btao732/ECE492/Platform/Platform.runs/impl_1/.init_design.begin.rst

<?xml version="1.0"?>
<ProcessHandle Version="1" Minor="0">
    <Process Command=".planAhead." Owner="Moose" Host="DESKTOP-4VIHOFO" Pid="2448">
    </Process>
</ProcessHandle>
