btao732/ECE492/Platform/Platform.runs/impl_1/.vivado.begin.rst

<?xml version="1.0"?>
<ProcessHandle Version="1" Minor="0">
    <Process Command="vivado.bat" Owner="Moose" Host="DESKTOP-4VIHOFO" Pid="16036" HostCore="16" HostMemory="016387657728">
    </Process>
</ProcessHandle>
