btao732/ECE492/PCB/SPARC Capstone Preliminary BOM.xlsx

Reference | Value | MFR | Mfr P/N | Mouser P/N | Digikey P/N | Qty | Unit Price | Ext Price | Notes
C1-C6 | 0.22uF | TDK | CGA6M4X7T2W224M200AA | 810-CGA6M4X7T2W224MA | 445-13048-1-ND | 10 | $0.74 | $7.45
C7, C9, C11, C12 | 0.1uF | Murata | GC332DD72W104KX01L | 81-GC332DD72W104KX1L | 490-14002-1-ND | 10 | $1.07 | $10.70
C8, C10 | 1uF | Samsung | CL10B105KP8NNNC | 187-CL10B105KP8NNNC | 1276-1946-1-ND | 10 | $0.06 | $0.56
D1 | Bridge Rectifier | Diodes Inc. | HDS10M-13 | 621-HDS10M-13 | HDS10M-13DICT-ND | 1 | $0.65 | $0.65 | As specified in given schematic
J1-J2 | SMA Connector | Molex | 732511150 | 538-73251-1150 | WM5534-ND | 2 | $6.41 | $12.82 | As specified in given schematic
J3, J6 | 6-Pin Header | Adam Tech | PH1-06-UA | 523-G800W302018EU | 2057-PH1-06-UA-ND | 2 | $0.19 | $0.38 | Mouser P/N is a different, compatable part
J4, J5, JP1 | 3-Pin header | Adam Tech | PH1-03-UA | 523-G800W305018EU | 2057-PH1-03-UA-ND | 3 | $0.15 | $0.45 | Mouser P/N is a different, compatable part
JP2-JP5 | 6-Pin Header | Adam Tech | PH2-06-UA |  | 2057-PH2-06-UA-ND | 2 | $0.19 | $0.38
R1-R62 | 75KΩ | Rohm | ESR03EZPF7502 | 755-ESR03EZPF7502 | RHM75.0KADCT-ND | 100 | $0.08 | $8.00
U1 | Switch | Microchip | HV2621/R4X | 579-HV2621/R4X | 150-HV2621/R4X-ND | 2 | $40.27 | $80.54 | $42.39 From Digikey
 |  |  |  |  |  |  | Total | $121.93
