btao732/ECE492/PCB/SPARC.kicad_pcb

## KiCad design PCB/SPARC.kicad_pcb (2023-03-10)

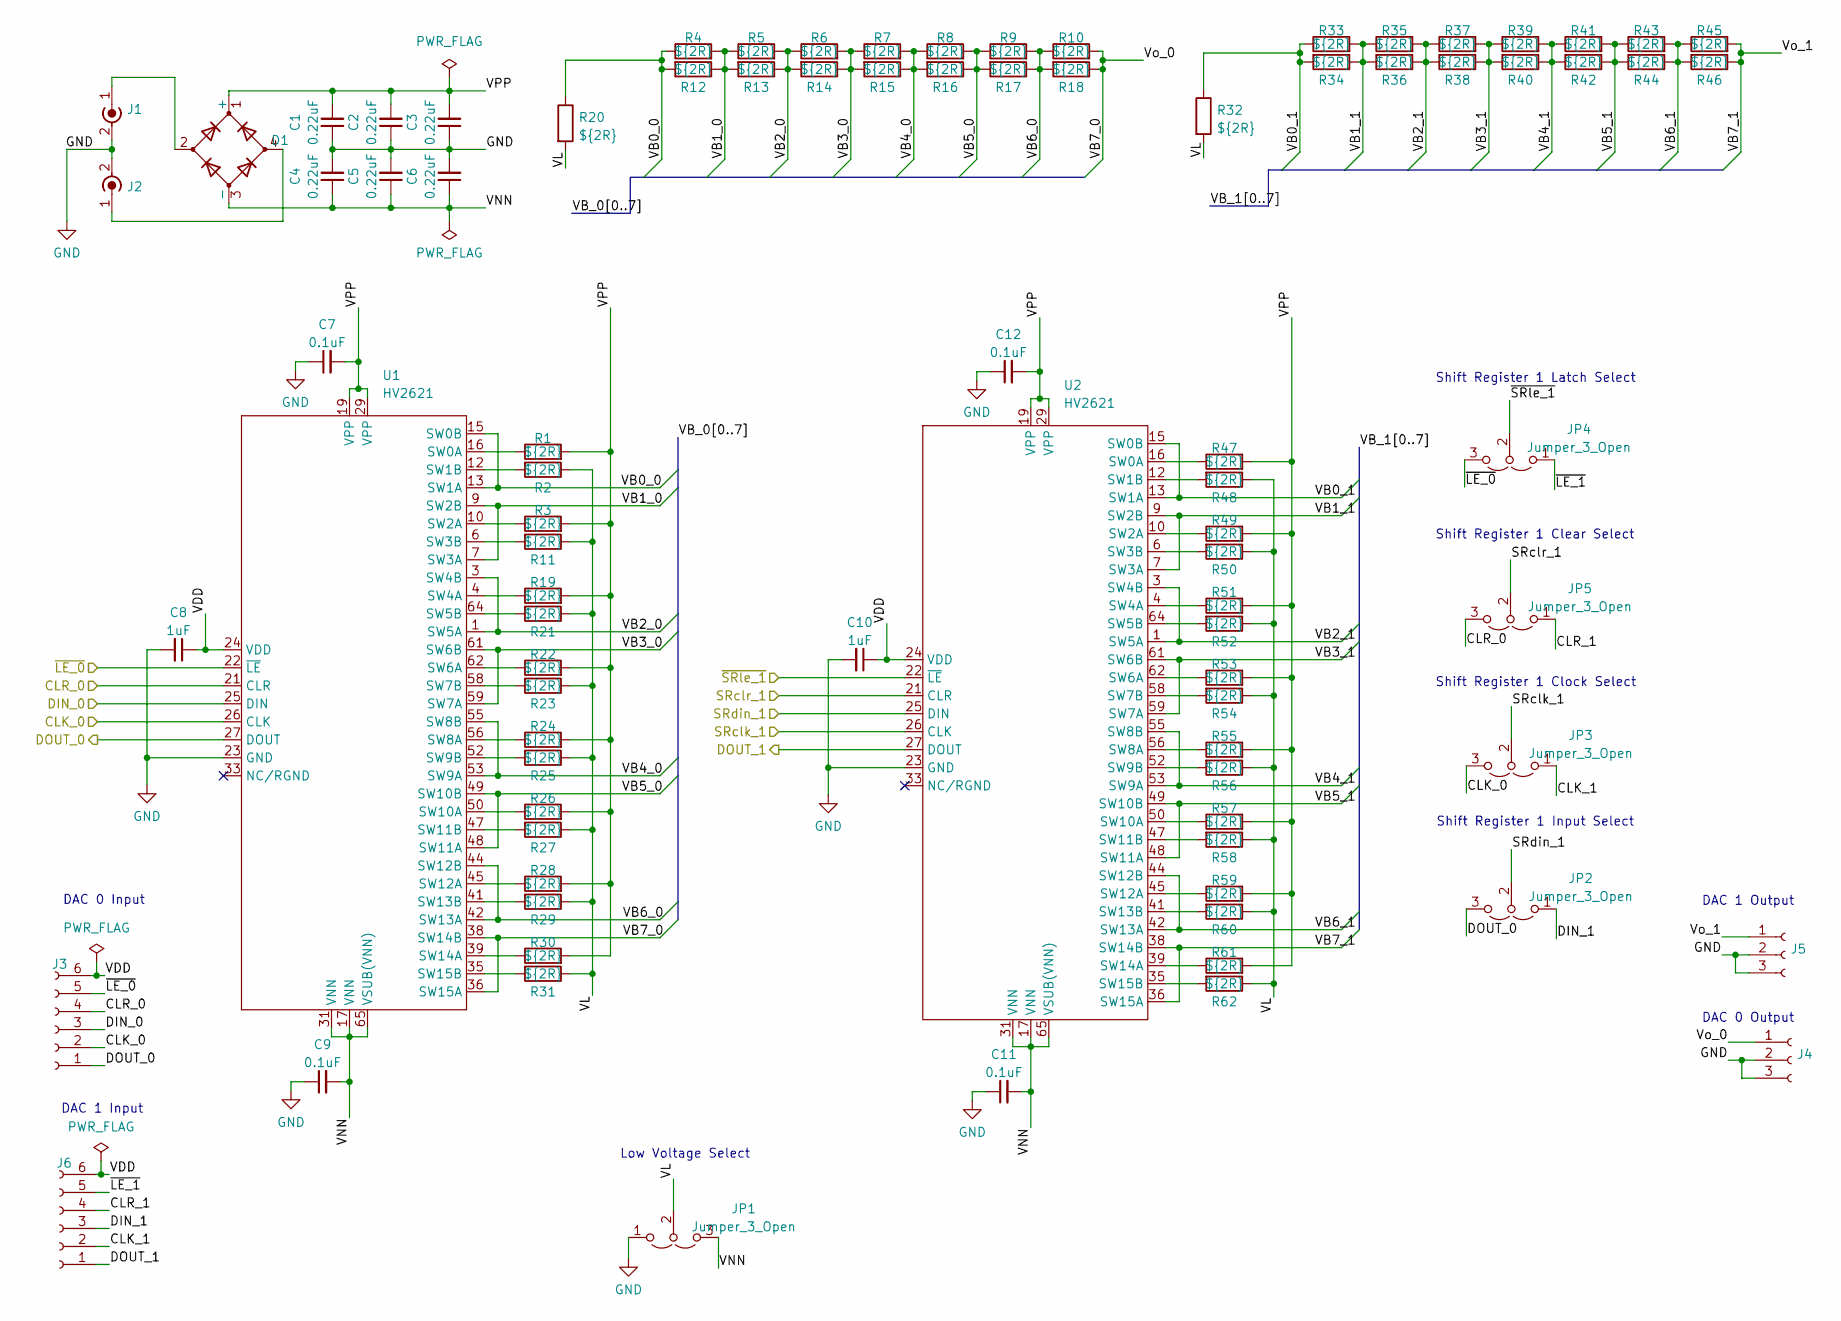
[picture p1: schematic SPARC.kicad_sch, HVDAC - SPARC Capstone]

Parts:
C1, C2, C3, C4, C5, C6: 0.22uF; C_1210_3225Metric
C7, C9, C11, C12: 0.1uF; C_1210_3225Metric_Pad1.33x2.70mm_HandSolder
C8, C10: 1uF; C_0603_1608Metric
D1: D_Bridge_+A-A; Package_HDS
J1, J2: Conn_Coaxial_Power; SMA_Molex_73251-1153_EdgeMount_Horizontal
J3, J6: Conn_01x06_Female; PinHeader_1x06_P2.54mm_Vertical
J4, J5: Conn_01x03_Female; PinHeader_1x03_P2.54mm_Vertical
JP1, JP2, JP3, JP4, JP5: Jumper_3_Open; PinHeader_1x03_P2.54mm_Vertical
R1, R2, R3, R4, R5, R6, R7, R8, R9, R10, R11, R12, R13, R14, R15, R16, R17, R18, R19, R20, R21, R22, R23, R24, R25, R26, R27, R28, R29, R30, R31, R32, R33, R34, R35, R36, R37, R38, R39, R40, R41, R42, R43, R44, R45, R46, R47, R48, R49, R50, R51, R52, R53, R54, R55, R56, R57, R58, R59, R60, R61, R62: ${2R}; R_0603_1608Metric_small_silk
U1, U2: HV2621; VQFN-64-1EP_9x9mm_P0.5mm_EP7.15x7.15mm_ThermalVias

Connections:
/CLK_0: J3.2, JP3.3 (B), U1.26 (CLK); also elsewhere on the board
/CLK_1: J6.2, JP3.1 (A); also elsewhere on the board
/CLR_0: J3.4, JP5.3 (B), U1.21 (CLR); also elsewhere on the board
/CLR_1: J6.4, JP5.1 (A); also elsewhere on the board
/DIN_0: J3.3, U1.25 (DIN)
/DIN_1: J6.3, JP2.1 (A); also elsewhere on the board
/DOUT_0: J3.1, JP2.3 (B), U1.27 (DOUT); also elsewhere on the board
/DOUT_1: J6.1, U2.27 (DOUT)
/SRclk_1: U2.26 (CLK); also elsewhere on the board
/SRclr_1: U2.21 (CLR); also elsewhere on the board
/SRdin_1: U2.25 (DIN); also elsewhere on the board
/VB0_0: R4.1, R12.2, R20.1, U1.13 (SW1A), U1.15 (SW0B)
/VB0_1: R32.1, R33.1, R34.2, U2.13 (SW1A), U2.15 (SW0B)
/VB1_0: R4.2, R5.1, R12.1, R13.2, U1.7 (SW3A), U1.9 (SW2B)
/VB1_1: R33.2, R34.1, R35.1, R36.2, U2.7 (SW3A), U2.9 (SW2B)
/VB2_0: R5.2, R6.1, R13.1, R14.2, U1.1 (SW5A), U1.3 (SW4B)
/VB2_1: R35.2, R36.1, R37.1, R38.2, U2.1 (SW5A), U2.3 (SW4B)
/VB3_0: R6.2, R7.1, R14.1, R15.2, U1.59 (SW7A), U1.61 (SW6B)
/VB3_1: R37.2, R38.1, R39.1, R40.2, U2.59 (SW7A), U2.61 (SW6B)
/VB4_0: R7.2, R8.1, R15.1, R16.2, U1.53 (SW9A), U1.55 (SW8B)
/VB4_1: R39.2, R40.1, R41.1, R42.2, U2.53 (SW9A), U2.55 (SW8B)
/VB5_0: R8.2, R9.1, R16.1, R17.2, U1.48 (SW11A), U1.49 (SW10B)
/VB5_1: R41.2, R42.1, R43.1, R44.2, U2.48 (SW11A), U2.49 (SW10B)
/VB6_0: R9.2, R10.1, R17.1, R18.2, U1.42 (SW13A), U1.44 (SW12B)
/VB6_1: R43.2, R44.1, R45.1, R46.2, U2.42 (SW13A), U2.44 (SW12B)
/VB7_0: J4.1, R10.2, R18.1, U1.36 (SW15A), U1.38 (SW14B)
/VB7_1: J5.1, R45.2, R46.1, U2.36 (SW15A), U2.38 (SW14B)
/VDD: C8.1, C10.1, J3.6, J6.6, U1.24 (VDD), U2.24 (VDD)
/VL: JP1.2 (C), R2.1, R11.1, R20.2, R21.1, R23.1, R25.1, R27.1, R29.1, R31.1, R32.2, R48.1, R50.1, R52.1, R54.1, R56.1, R58.1, R60.1, R62.1
/VNN: C4.1, C5.1, C6.1, C9.2, C11.2, D1.3 (-), JP1.3 (B), U1.17 (VNN), U1.31 (VNN), U1.65 (VSUB(VNN)), U2.17 (VNN), U2.31 (VNN), U2.65 (VSUB(VNN))
/VPP: C1.2, C2.2, C3.2, C7.2, C12.2, D1.1 (+), R1.2, R3.2, R19.2, R22.2, R24.2, R26.2, R28.2, R30.2, R47.2, R49.2, R51.2, R53.2, R55.2, R57.2, R59.2, R61.2, U1.19 (VPP), U1.29 (VPP), U2.19 (VPP), U2.29 (VPP); also elsewhere on the board
/~LE_0: J3.5, JP4.3 (B), U1.22 (~LE); also elsewhere on the board
/~LE_1: J6.5, JP4.1 (A); also elsewhere on the board
/~SRle_1: U2.22 (~LE); also elsewhere on the board
GND: C1.1, C2.1, C3.1, C4.2, C5.2, C6.2, C7.1, C8.2, C9.1, C10.2, C11.1, C12.1, J1.2 (Ext), J2.2 (Ext), J4.2, J4.3, J5.2, J5.3, JP1.1 (A), U1.23 (GND), U2.23 (GND)
unnamed: D1.2, J1.1 (In)
unnamed: D1.4, J2.1 (In)
unnamed: R1.1, U1.16 (SW0A)
unnamed: R2.2, U1.12 (SW1B)
unnamed: R3.1, U1.10 (SW2A)
unnamed: R11.2, U1.6 (SW3B)
unnamed: R19.1, U1.4 (SW4A)
unnamed: R21.2, U1.64 (SW5B)
unnamed: R22.1, U1.62 (SW6A)
unnamed: R23.2, U1.58 (SW7B)
unnamed: R24.1, U1.56 (SW8A)
unnamed: R25.2, U1.52 (SW9B)
unnamed: R26.1, U1.50 (SW10A)
unnamed: R27.2, U1.47 (SW11B)
unnamed: R28.1, U1.45 (SW12A)
unnamed: R29.2, U1.41 (SW13B)
unnamed: R30.1, U1.39 (SW14A)
unnamed: R31.2, U1.35 (SW15B)
unnamed: R47.1, U2.16 (SW0A)
unnamed: R48.2, U2.12 (SW1B)
unnamed: R49.1, U2.10 (SW2A)
unnamed: R50.2, U2.6 (SW3B)
unnamed: R51.1, U2.4 (SW4A)
unnamed: R52.2, U2.64 (SW5B)
unnamed: R53.1, U2.62 (SW6A)
unnamed: R54.2, U2.58 (SW7B)
unnamed: R55.1, U2.56 (SW8A)
unnamed: R56.2, U2.52 (SW9B)
unnamed 63: R57.1, U2.50 (SW10A); also elsewhere on the board
unnamed: R58.2, U2.47 (SW11B)
unnamed: R59.1, U2.45 (SW12A)
unnamed: R60.2, U2.41 (SW13B)
unnamed: R61.1, U2.39 (SW14A)
unnamed: R62.2, U2.35 (SW15B)

Notes on the sheet:
DAC 1 Output
Low Voltage Select
DAC 0 Output
Shift Register 1 Clear Select
Shift Register 1 Latch Select
DAC 1 Input
DAC 0 Input
Shift Register 1 Input Select
Shift Register 1 Clock Select

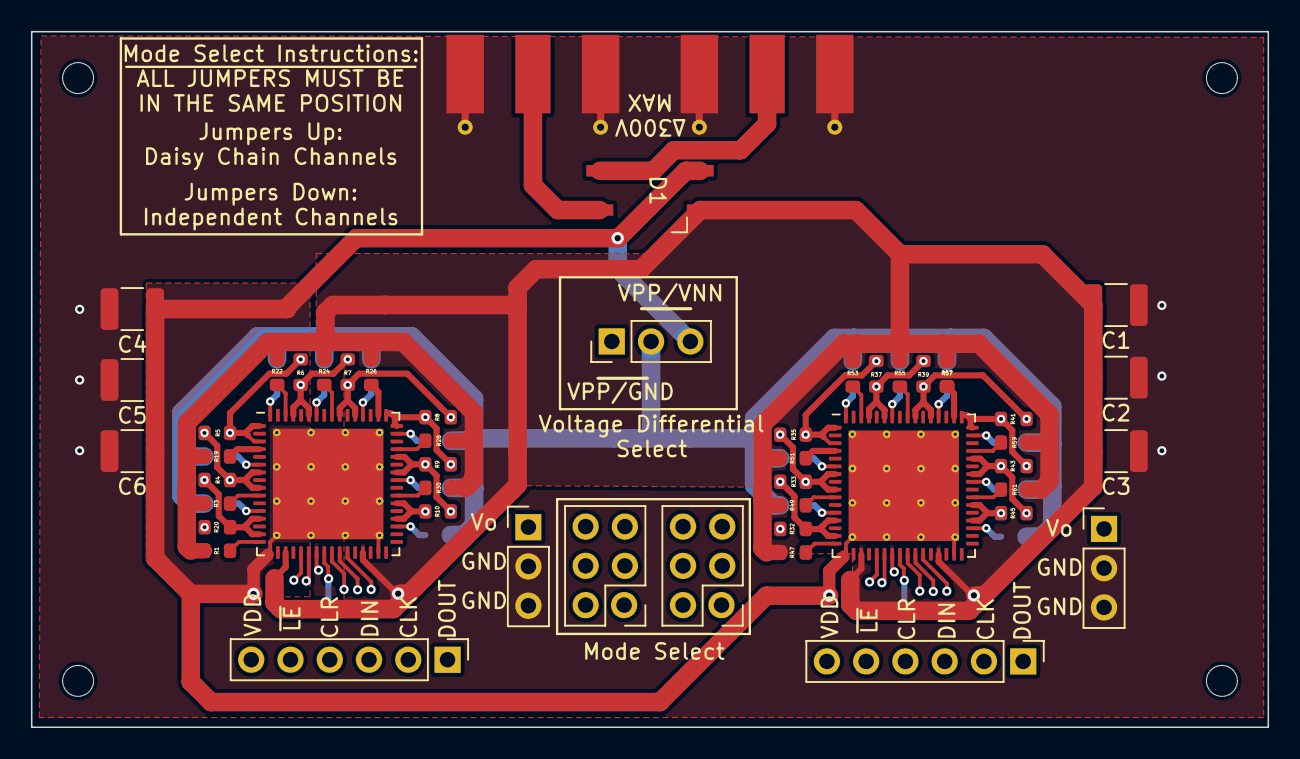
[picture p2: board SPARC.kicad_pcb from above]

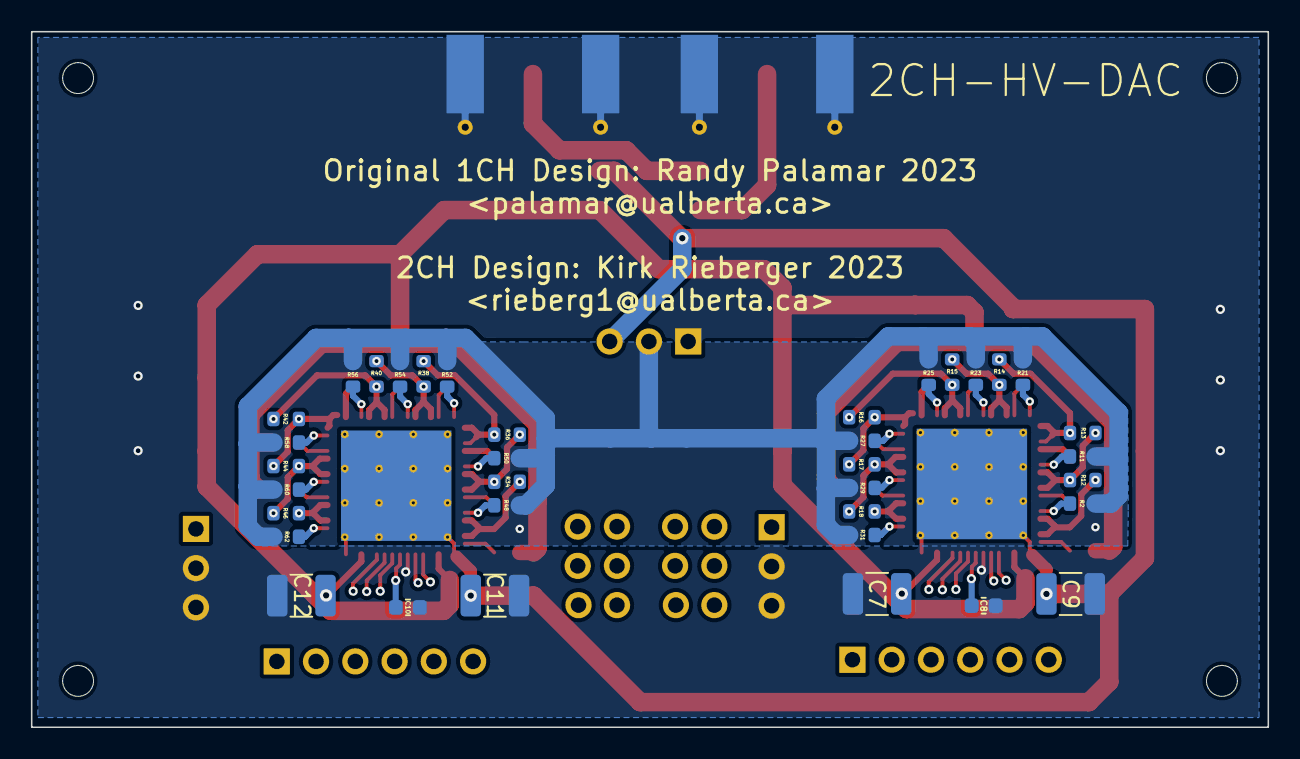
[picture p3: board SPARC.kicad_pcb from below]

Board: 4 copper layers, 80.0 x 45.0 mm, 87 parts (36 on the bottom side), 69 nets.

Other parts of the board:
JP3 JP2, JP4 JP5: PinHeader_2x03_P2.54mm_Vertical
R57#2: ${2R}; R_0603_1608Metric_small_silk

Their connections:
/CLK_0: JP3 JP2.6; also elsewhere on the board
/CLK_1: JP3 JP2.2; also elsewhere on the board
/CLR_0: JP4 JP5.5; also elsewhere on the board
/CLR_1: JP4 JP5.1; also elsewhere on the board
/DIN_1: JP3 JP2.1; also elsewhere on the board
/DOUT_0: JP3 JP2.5; also elsewhere on the board
/SRclk_1: JP3 JP2.4; also elsewhere on the board
/SRclr_1: JP4 JP5.3; also elsewhere on the board
/SRdin_1: JP3 JP2.3; also elsewhere on the board
/VPP: R57#2.2; also elsewhere on the board
/~LE_0: JP4 JP5.6; also elsewhere on the board
/~LE_1: JP4 JP5.2; also elsewhere on the board
/~SRle_1: JP4 JP5.4; also elsewhere on the board
unnamed 63: R57#2.1; also elsewhere on the board
