btao732/ECE492/Platform/Platform.cache/ip/2022.1/3/1/31d6ee4502b99f54/system_proc_sys_reset_0_0_stub.v

// Copyright 1986-2022 Xilinx, Inc. All Rights Reserved.
// --------------------------------------------------------------------------------
// Tool Version: Vivado v.2022.1 (win64) Build 3526262 Mon Apr 18 15:48:16 MDT 2022
// Date        : Tue Jan 31 09:18:14 2023
// Host        : DESKTOP-4VIHOFO running 64-bit major release  (build 9200)
// Command     : write_verilog -force -mode synth_stub -rename_top decalper_eb_ot_sdeen_pot_pi_dehcac_xnilix -prefix
//               decalper_eb_ot_sdeen_pot_pi_dehcac_xnilix_ system_proc_sys_reset_0_0_stub.v
// Design      : system_proc_sys_reset_0_0
// Purpose     : Stub declaration of top-level module interface
// Device      : xc7z010clg400-1
// --------------------------------------------------------------------------------

// This empty module with port declaration file causes synthesis tools to infer a black box for IP.
// The synthesis directives are for Synopsys Synplify support to prevent IO buffer insertion.
// Please paste the declaration into a Verilog source file or add the file as an additional source.
(* x_core_info = "proc_sys_reset,Vivado 2022.1" *)
module decalper_eb_ot_sdeen_pot_pi_dehcac_xnilix(slowest_sync_clk, ext_reset_in, aux_reset_in, 
  mb_debug_sys_rst, dcm_locked, mb_reset, bus_struct_reset, peripheral_reset, 
  interconnect_aresetn, peripheral_aresetn)
/* synthesis syn_black_box black_box_pad_pin="slowest_sync_clk,ext_reset_in,aux_reset_in,mb_debug_sys_rst,dcm_locked,mb_reset,bus_struct_reset[0:0],peripheral_reset[0:0],interconnect_aresetn[0:0],peripheral_aresetn[0:0]" */;
  input slowest_sync_clk;
  input ext_reset_in;
  input aux_reset_in;
  input mb_debug_sys_rst;
  input dcm_locked;
  output mb_reset;
  output [0:0]bus_struct_reset;
  output [0:0]peripheral_reset;
  output [0:0]interconnect_aresetn;
  output [0:0]peripheral_aresetn;
endmodule
