btao732/ECE492/Platform/Platform.gen/sources_1/bd/system/ip/system_processing_system7_0_0/sim/system_processing_system7_0_0.h

#ifndef IP_SYSTEM_PROCESSING_SYSTEM7_0_0_H_
#define IP_SYSTEM_PROCESSING_SYSTEM7_0_0_H_

// (c) Copyright 1995-2023 Xilinx, Inc. All rights reserved.
// 
// This file contains confidential and proprietary information
// of Xilinx, Inc. and is protected under U.S. and
// international copyright and other intellectual property
// laws.
// 
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
// CRITICAL APPLICATIONS
// Xilinx products are not designed or intended to be fail-
// safe, or for use in any application requiring fail-safe
// performance, such as life-support or safety devices or
// systems, Class III medical devices, nuclear facilities,
// applications related to the deployment of airbags, or any
// other applications that could lead to death, personal
// injury, or severe property or environmental damage
// (individually and collectively, "Critical
// Applications"). Customer assumes the sole risk and
// liability of any use of Xilinx products in Critical
// Applications, subject only to applicable laws and
// regulations governing limitations on product liability.
// 
// THIS COPYRIGHT NOTICE AND DISCLAIMER MUST BE RETAINED AS
// PART OF THIS FILE AT ALL TIMES.
// 
// DO NOT MODIFY THIS FILE.


#ifndef XTLM
#include "xtlm.h"
#endif
#ifndef SYSTEMC_INCLUDED
#include <systemc>
#endif

#if defined(_MSC_VER)
#define DllExport __declspec(dllexport)
#elif defined(__GNUC__)
#define DllExport __attribute__ ((visibility("default")))
#else
#define DllExport
#endif

#include "system_processing_system7_0_0_sc.h"




#ifdef XILINX_SIMULATOR
class DllExport system_processing_system7_0_0 : public system_processing_system7_0_0_sc
{
public:

  system_processing_system7_0_0(const sc_core::sc_module_name& nm);
  virtual ~system_processing_system7_0_0();

  // module pin-to-pin RTL interface

  sc_core::sc_out< sc_dt::sc_bv<2> > USB0_PORT_INDCTL;
  sc_core::sc_out< bool > USB0_VBUS_PWRSELECT;
  sc_core::sc_in< bool > USB0_VBUS_PWRFAULT;
  sc_core::sc_out< bool > M_AXI_GP0_ARVALID;
  sc_core::sc_out< bool > M_AXI_GP0_AWVALID;
  sc_core::sc_out< bool > M_AXI_GP0_BREADY;
  sc_core::sc_out< bool > M_AXI_GP0_RREADY;
  sc_core::sc_out< bool > M_AXI_GP0_WLAST;
  sc_core::sc_out< bool > M_AXI_GP0_WVALID;
  sc_core::sc_out< sc_dt::sc_bv<12> > M_AXI_GP0_ARID;
  sc_core::sc_out< sc_dt::sc_bv<12> > M_AXI_GP0_AWID;
  sc_core::sc_out< sc_dt::sc_bv<12> > M_AXI_GP0_WID;
  sc_core::sc_out< sc_dt::sc_bv<2> > M_AXI_GP0_ARBURST;
  sc_core::sc_out< sc_dt::sc_bv<2> > M_AXI_GP0_ARLOCK;
  sc_core::sc_out< sc_dt::sc_bv<3> > M_AXI_GP0_ARSIZE;
  sc_core::sc_out< sc_dt::sc_bv<2> > M_AXI_GP0_AWBURST;
  sc_core::sc_out< sc_dt::sc_bv<2> > M_AXI_GP0_AWLOCK;
  sc_core::sc_out< sc_dt::sc_bv<3> > M_AXI_GP0_AWSIZE;
  sc_core::sc_out< sc_dt::sc_bv<3> > M_AXI_GP0_ARPROT;
  sc_core::sc_out< sc_dt::sc_bv<3> > M_AXI_GP0_AWPROT;
  sc_core::sc_out< sc_dt::sc_bv<32> > M_AXI_GP0_ARADDR;
  sc_core::sc_out< sc_dt::sc_bv<32> > M_AXI_GP0_AWADDR;
  sc_core::sc_out< sc_dt::sc_bv<32> > M_AXI_GP0_WDATA;
  sc_core::sc_out< sc_dt::sc_bv<4> > M_AXI_GP0_ARCACHE;
  sc_core::sc_out< sc_dt::sc_bv<4> > M_AXI_GP0_ARLEN;
  sc_core::sc_out< sc_dt::sc_bv<4> > M_AXI_GP0_ARQOS;
  sc_core::sc_out< sc_dt::sc_bv<4> > M_AXI_GP0_AWCACHE;
  sc_core::sc_out< sc_dt::sc_bv<4> > M_AXI_GP0_AWLEN;
  sc_core::sc_out< sc_dt::sc_bv<4> > M_AXI_GP0_AWQOS;
  sc_core::sc_out< sc_dt::sc_bv<4> > M_AXI_GP0_WSTRB;
  sc_core::sc_in< bool > M_AXI_GP0_ACLK;
  sc_core::sc_in< bool > M_AXI_GP0_ARREADY;
  sc_core::sc_in< bool > M_AXI_GP0_AWREADY;
  sc_core::sc_in< bool > M_AXI_GP0_BVALID;
  sc_core::sc_in< bool > M_AXI_GP0_RLAST;
  sc_core::sc_in< bool > M_AXI_GP0_RVALID;
  sc_core::sc_in< bool > M_AXI_GP0_WREADY;
  sc_core::sc_in< sc_dt::sc_bv<12> > M_AXI_GP0_BID;
  sc_core::sc_in< sc_dt::sc_bv<12> > M_AXI_GP0_RID;
  sc_core::sc_in< sc_dt::sc_bv<2> > M_AXI_GP0_BRESP;
  sc_core::sc_in< sc_dt::sc_bv<2> > M_AXI_GP0_RRESP;
  sc_core::sc_in< sc_dt::sc_bv<32> > M_AXI_GP0_RDATA;
  sc_core::sc_out< bool > FCLK_CLK0;
  sc_core::sc_out< bool > FCLK_RESET0_N;
  sc_core::sc_out< sc_dt::sc_bv<54> > MIO;
  sc_core::sc_out< bool > DDR_CAS_n;
  sc_core::sc_out< bool > DDR_CKE;
  sc_core::sc_out< bool > DDR_Clk_n;
  sc_core::sc_out< bool > DDR_Clk;
  sc_core::sc_out< bool > DDR_CS_n;
  sc_core::sc_out< bool > DDR_DRSTB;
  sc_core::sc_out< bool > DDR_ODT;
  sc_core::sc_out< bool > DDR_RAS_n;
  sc_core::sc_out< bool > DDR_WEB;
  sc_core::sc_out< sc_dt::sc_bv<3> > DDR_BankAddr;
  sc_core::sc_out< sc_dt::sc_bv<15> > DDR_Addr;
  sc_core::sc_out< bool > DDR_VRN;
  sc_core::sc_out< bool > DDR_VRP;
  sc_core::sc_out< sc_dt::sc_bv<4> > DDR_DM;
  sc_core::sc_out< sc_dt::sc_bv<32> > DDR_DQ;
  sc_core::sc_out< sc_dt::sc_bv<4> > DDR_DQS_n;
  sc_core::sc_out< sc_dt::sc_bv<4> > DDR_DQS;
  sc_core::sc_out< bool > PS_SRSTB;
  sc_core::sc_out< bool > PS_CLK;
  sc_core::sc_out< bool > PS_PORB;

  // Dummy Signals for IP Ports


protected:

  virtual void before_end_of_elaboration();

private:

  xtlm::xaximm_xtlm2pin_t<32,32,12,1,1,1,1,1>* mp_M_AXI_GP0_transactor;
  xsc::common::scalar2vectorN_converter<2>* mp_M_AXI_GP0_ARLOCK_converter;
  sc_signal< bool > m_M_AXI_GP0_ARLOCK_converter_signal;
  xsc::common::scalar2vectorN_converter<2>* mp_M_AXI_GP0_AWLOCK_converter;
  sc_signal< bool > m_M_AXI_GP0_AWLOCK_converter_signal;
  xsc::common::vector2vector_converter<8,4>* mp_M_AXI_GP0_ARLEN_converter;
  sc_signal< sc_bv<8> > m_M_AXI_GP0_ARLEN_converter_signal;
  xsc::common::vector2vector_converter<8,4>* mp_M_AXI_GP0_AWLEN_converter;
  sc_signal< sc_bv<8> > m_M_AXI_GP0_AWLEN_converter_signal;
  sc_signal< bool > m_M_AXI_GP0_transactor_rst_signal;

};
#endif // XILINX_SIMULATOR




#ifdef XM_SYSTEMC
class DllExport system_processing_system7_0_0 : public system_processing_system7_0_0_sc
{
public:

  system_processing_system7_0_0(const sc_core::sc_module_name& nm);
  virtual ~system_processing_system7_0_0();

  // module pin-to-pin RTL interface

  sc_core::sc_out< sc_dt::sc_bv<2> > USB0_PORT_INDCTL;
  sc_core::sc_out< bool > USB0_VBUS_PWRSELECT;
  sc_core::sc_in< bool > USB0_VBUS_PWRFAULT;
  sc_core::sc_out< bool > M_AXI_GP0_ARVALID;
  sc_core::sc_out< bool > M_AXI_GP0_AWVALID;
  sc_core::sc_out< bool > M_AXI_GP0_BREADY;
  sc_core::sc_out< bool > M_AXI_GP0_RREADY;
  sc_core::sc_out< bool > M_AXI_GP0_WLAST;
  sc_core::sc_out< bool > M_AXI_GP0_WVALID;
  sc_core::sc_out< sc_dt::sc_bv<12> > M_AXI_GP0_ARID;
  sc_core::sc_out< sc_dt::sc_bv<12> > M_AXI_GP0_AWID;
  sc_core::sc_out< sc_dt::sc_bv<12> > M_AXI_GP0_WID;
  sc_core::sc_out< sc_dt::sc_bv<2> > M_AXI_GP0_ARBURST;
  sc_core::sc_out< sc_dt::sc_bv<2> > M_AXI_GP0_ARLOCK;
  sc_core::sc_out< sc_dt::sc_bv<3> > M_AXI_GP0_ARSIZE;
  sc_core::sc_out< sc_dt::sc_bv<2> > M_AXI_GP0_AWBURST;
  sc_core::sc_out< sc_dt::sc_bv<2> > M_AXI_GP0_AWLOCK;
  sc_core::sc_out< sc_dt::sc_bv<3> > M_AXI_GP0_AWSIZE;
  sc_core::sc_out< sc_dt::sc_bv<3> > M_AXI_GP0_ARPROT;
  sc_core::sc_out< sc_dt::sc_bv<3> > M_AXI_GP0_AWPROT;
  sc_core::sc_out< sc_dt::sc_bv<32> > M_AXI_GP0_ARADDR;
  sc_core::sc_out< sc_dt::sc_bv<32> > M_AXI_GP0_AWADDR;
  sc_core::sc_out< sc_dt::sc_bv<32> > M_AXI_GP0_WDATA;
  sc_core::sc_out< sc_dt::sc_bv<4> > M_AXI_GP0_ARCACHE;
  sc_core::sc_out< sc_dt::sc_bv<4> > M_AXI_GP0_ARLEN;
  sc_core::sc_out< sc_dt::sc_bv<4> > M_AXI_GP0_ARQOS;
  sc_core::sc_out< sc_dt::sc_bv<4> > M_AXI_GP0_AWCACHE;
  sc_core::sc_out< sc_dt::sc_bv<4> > M_AXI_GP0_AWLEN;
  sc_core::sc_out< sc_dt::sc_bv<4> > M_AXI_GP0_AWQOS;
  sc_core::sc_out< sc_dt::sc_bv<4> > M_AXI_GP0_WSTRB;
  sc_core::sc_in< bool > M_AXI_GP0_ACLK;
  sc_core::sc_in< bool > M_AXI_GP0_ARREADY;
  sc_core::sc_in< bool > M_AXI_GP0_AWREADY;
  sc_core::sc_in< bool > M_AXI_GP0_BVALID;
  sc_core::sc_in< bool > M_AXI_GP0_RLAST;
  sc_core::sc_in< bool > M_AXI_GP0_RVALID;
  sc_core::sc_in< bool > M_AXI_GP0_WREADY;
  sc_core::sc_in< sc_dt::sc_bv<12> > M_AXI_GP0_BID;
  sc_core::sc_in< sc_dt::sc_bv<12> > M_AXI_GP0_RID;
  sc_core::sc_in< sc_dt::sc_bv<2> > M_AXI_GP0_BRESP;
  sc_core::sc_in< sc_dt::sc_bv<2> > M_AXI_GP0_RRESP;
  sc_core::sc_in< sc_dt::sc_bv<32> > M_AXI_GP0_RDATA;
  sc_core::sc_out< bool > FCLK_CLK0;
  sc_core::sc_out< bool > FCLK_RESET0_N;
  sc_core::sc_inout< sc_dt::sc_bv<54> > MIO;
  sc_core::sc_inout< bool > DDR_CAS_n;
  sc_core::sc_inout< bool > DDR_CKE;
  sc_core::sc_inout< bool > DDR_Clk_n;
  sc_core::sc_inout< bool > DDR_Clk;
  sc_core::sc_inout< bool > DDR_CS_n;
  sc_core::sc_inout< bool > DDR_DRSTB;
  sc_core::sc_inout< bool > DDR_ODT;
  sc_core::sc_inout< bool > DDR_RAS_n;
  sc_core::sc_inout< bool > DDR_WEB;
  sc_core::sc_inout< sc_dt::sc_bv<3> > DDR_BankAddr;
  sc_core::sc_inout< sc_dt::sc_bv<15> > DDR_Addr;
  sc_core::sc_inout< bool > DDR_VRN;
  sc_core::sc_inout< bool > DDR_VRP;
  sc_core::sc_inout< sc_dt::sc_bv<4> > DDR_DM;
  sc_core::sc_inout< sc_dt::sc_bv<32> > DDR_DQ;
  sc_core::sc_inout< sc_dt::sc_bv<4> > DDR_DQS_n;
  sc_core::sc_inout< sc_dt::sc_bv<4> > DDR_DQS;
  sc_core::sc_inout< bool > PS_SRSTB;
  sc_core::sc_inout< bool > PS_CLK;
  sc_core::sc_inout< bool > PS_PORB;

  // Dummy Signals for IP Ports


protected:

  virtual void before_end_of_elaboration();

private:

  xtlm::xaximm_xtlm2pin_t<32,32,12,1,1,1,1,1>* mp_M_AXI_GP0_transactor;
  xsc::common::scalar2vectorN_converter<2>* mp_M_AXI_GP0_ARLOCK_converter;
  sc_signal< bool > m_M_AXI_GP0_ARLOCK_converter_signal;
  xsc::common::scalar2vectorN_converter<2>* mp_M_AXI_GP0_AWLOCK_converter;
  sc_signal< bool > m_M_AXI_GP0_AWLOCK_converter_signal;
  xsc::common::vector2vector_converter<8,4>* mp_M_AXI_GP0_ARLEN_converter;
  sc_signal< sc_bv<8> > m_M_AXI_GP0_ARLEN_converter_signal;
  xsc::common::vector2vector_converter<8,4>* mp_M_AXI_GP0_AWLEN_converter;
  sc_signal< sc_bv<8> > m_M_AXI_GP0_AWLEN_converter_signal;
  sc_signal< bool > m_M_AXI_GP0_transactor_rst_signal;

};
#endif // XM_SYSTEMC




#ifdef RIVIERA
class DllExport system_processing_system7_0_0 : public system_processing_system7_0_0_sc
{
public:

  system_processing_system7_0_0(const sc_core::sc_module_name& nm);
  virtual ~system_processing_system7_0_0();

  // module pin-to-pin RTL interface

  sc_core::sc_out< sc_dt::sc_bv<2> > USB0_PORT_INDCTL;
  sc_core::sc_out< bool > USB0_VBUS_PWRSELECT;
  sc_core::sc_in< bool > USB0_VBUS_PWRFAULT;
  sc_core::sc_out< bool > M_AXI_GP0_ARVALID;
  sc_core::sc_out< bool > M_AXI_GP0_AWVALID;
  sc_core::sc_out< bool > M_AXI_GP0_BREADY;
  sc_core::sc_out< bool > M_AXI_GP0_RREADY;
  sc_core::sc_out< bool > M_AXI_GP0_WLAST;
  sc_core::sc_out< bool > M_AXI_GP0_WVALID;
  sc_core::sc_out< sc_dt::sc_bv<12> > M_AXI_GP0_ARID;
  sc_core::sc_out< sc_dt::sc_bv<12> > M_AXI_GP0_AWID;
  sc_core::sc_out< sc_dt::sc_bv<12> > M_AXI_GP0_WID;
  sc_core::sc_out< sc_dt::sc_bv<2> > M_AXI_GP0_ARBURST;
  sc_core::sc_out< sc_dt::sc_bv<2> > M_AXI_GP0_ARLOCK;
  sc_core::sc_out< sc_dt::sc_bv<3> > M_AXI_GP0_ARSIZE;
  sc_core::sc_out< sc_dt::sc_bv<2> > M_AXI_GP0_AWBURST;
  sc_core::sc_out< sc_dt::sc_bv<2> > M_AXI_GP0_AWLOCK;
  sc_core::sc_out< sc_dt::sc_bv<3> > M_AXI_GP0_AWSIZE;
  sc_core::sc_out< sc_dt::sc_bv<3> > M_AXI_GP0_ARPROT;
  sc_core::sc_out< sc_dt::sc_bv<3> > M_AXI_GP0_AWPROT;
  sc_core::sc_out< sc_dt::sc_bv<32> > M_AXI_GP0_ARADDR;
  sc_core::sc_out< sc_dt::sc_bv<32> > M_AXI_GP0_AWADDR;
  sc_core::sc_out< sc_dt::sc_bv<32> > M_AXI_GP0_WDATA;
  sc_core::sc_out< sc_dt::sc_bv<4> > M_AXI_GP0_ARCACHE;
  sc_core::sc_out< sc_dt::sc_bv<4> > M_AXI_GP0_ARLEN;
  sc_core::sc_out< sc_dt::sc_bv<4> > M_AXI_GP0_ARQOS;
  sc_core::sc_out< sc_dt::sc_bv<4> > M_AXI_GP0_AWCACHE;
  sc_core::sc_out< sc_dt::sc_bv<4> > M_AXI_GP0_AWLEN;
  sc_core::sc_out< sc_dt::sc_bv<4> > M_AXI_GP0_AWQOS;
  sc_core::sc_out< sc_dt::sc_bv<4> > M_AXI_GP0_WSTRB;
  sc_core::sc_in< bool > M_AXI_GP0_ACLK;
  sc_core::sc_in< bool > M_AXI_GP0_ARREADY;
  sc_core::sc_in< bool > M_AXI_GP0_AWREADY;
  sc_core::sc_in< bool > M_AXI_GP0_BVALID;
  sc_core::sc_in< bool > M_AXI_GP0_RLAST;
  sc_core::sc_in< bool > M_AXI_GP0_RVALID;
  sc_core::sc_in< bool > M_AXI_GP0_WREADY;
  sc_core::sc_in< sc_dt::sc_bv<12> > M_AXI_GP0_BID;
  sc_core::sc_in< sc_dt::sc_bv<12> > M_AXI_GP0_RID;
  sc_core::sc_in< sc_dt::sc_bv<2> > M_AXI_GP0_BRESP;
  sc_core::sc_in< sc_dt::sc_bv<2> > M_AXI_GP0_RRESP;
  sc_core::sc_in< sc_dt::sc_bv<32> > M_AXI_GP0_RDATA;
  sc_core::sc_out< bool > FCLK_CLK0;
  sc_core::sc_out< bool > FCLK_RESET0_N;
  sc_core::sc_out< sc_dt::sc_bv<54> > MIO;
  sc_core::sc_out< bool > DDR_CAS_n;
  sc_core::sc_out< bool > DDR_CKE;
  sc_core::sc_out< bool > DDR_Clk_n;
  sc_core::sc_out< bool > DDR_Clk;
  sc_core::sc_out< bool > DDR_CS_n;
  sc_core::sc_out< bool > DDR_DRSTB;
  sc_core::sc_out< bool > DDR_ODT;
  sc_core::sc_out< bool > DDR_RAS_n;
  sc_core::sc_out< bool > DDR_WEB;
  sc_core::sc_out< sc_dt::sc_bv<3> > DDR_BankAddr;
  sc_core::sc_out< sc_dt::sc_bv<15> > DDR_Addr;
  sc_core::sc_out< bool > DDR_VRN;
  sc_core::sc_out< bool > DDR_VRP;
  sc_core::sc_out< sc_dt::sc_bv<4> > DDR_DM;
  sc_core::sc_out< sc_dt::sc_bv<32> > DDR_DQ;
  sc_core::sc_out< sc_dt::sc_bv<4> > DDR_DQS_n;
  sc_core::sc_out< sc_dt::sc_bv<4> > DDR_DQS;
  sc_core::sc_out< bool > PS_SRSTB;
  sc_core::sc_out< bool > PS_CLK;
  sc_core::sc_out< bool > PS_PORB;

  // Dummy Signals for IP Ports


protected:

  virtual void before_end_of_elaboration();

private:

  xtlm::xaximm_xtlm2pin_t<32,32,12,1,1,1,1,1>* mp_M_AXI_GP0_transactor;
  xsc::common::scalar2vectorN_converter<2>* mp_M_AXI_GP0_ARLOCK_converter;
  sc_signal< bool > m_M_AXI_GP0_ARLOCK_converter_signal;
  xsc::common::scalar2vectorN_converter<2>* mp_M_AXI_GP0_AWLOCK_converter;
  sc_signal< bool > m_M_AXI_GP0_AWLOCK_converter_signal;
  xsc::common::vector2vector_converter<8,4>* mp_M_AXI_GP0_ARLEN_converter;
  sc_signal< sc_bv<8> > m_M_AXI_GP0_ARLEN_converter_signal;
  xsc::common::vector2vector_converter<8,4>* mp_M_AXI_GP0_AWLEN_converter;
  sc_signal< sc_bv<8> > m_M_AXI_GP0_AWLEN_converter_signal;
  sc_signal< bool > m_M_AXI_GP0_transactor_rst_signal;

};
#endif // RIVIERA




#ifdef VCSSYSTEMC
#include "utils/xtlm_aximm_initiator_stub.h"

class DllExport system_processing_system7_0_0 : public system_processing_system7_0_0_sc
{
public:

  system_processing_system7_0_0(const sc_core::sc_module_name& nm);
  virtual ~system_processing_system7_0_0();

  // module pin-to-pin RTL interface

  sc_core::sc_out< sc_dt::sc_bv<2> > USB0_PORT_INDCTL;
  sc_core::sc_out< bool > USB0_VBUS_PWRSELECT;
  sc_core::sc_in< bool > USB0_VBUS_PWRFAULT;
  sc_core::sc_out< bool > M_AXI_GP0_ARVALID;
  sc_core::sc_out< bool > M_AXI_GP0_AWVALID;
  sc_core::sc_out< bool > M_AXI_GP0_BREADY;
  sc_core::sc_out< bool > M_AXI_GP0_RREADY;
  sc_core::sc_out< bool > M_AXI_GP0_WLAST;
  sc_core::sc_out< bool > M_AXI_GP0_WVALID;
  sc_core::sc_out< sc_dt::sc_bv<12> > M_AXI_GP0_ARID;
  sc_core::sc_out< sc_dt::sc_bv<12> > M_AXI_GP0_AWID;
  sc_core::sc_out< sc_dt::sc_bv<12> > M_AXI_GP0_WID;
  sc_core::sc_out< sc_dt::sc_bv<2> > M_AXI_GP0_ARBURST;
  sc_core::sc_out< sc_dt::sc_bv<2> > M_AXI_GP0_ARLOCK;
  sc_core::sc_out< sc_dt::sc_bv<3> > M_AXI_GP0_ARSIZE;
  sc_core::sc_out< sc_dt::sc_bv<2> > M_AXI_GP0_AWBURST;
  sc_core::sc_out< sc_dt::sc_bv<2> > M_AXI_GP0_AWLOCK;
  sc_core::sc_out< sc_dt::sc_bv<3> > M_AXI_GP0_AWSIZE;
  sc_core::sc_out< sc_dt::sc_bv<3> > M_AXI_GP0_ARPROT;
  sc_core::sc_out< sc_dt::sc_bv<3> > M_AXI_GP0_AWPROT;
  sc_core::sc_out< sc_dt::sc_bv<32> > M_AXI_GP0_ARADDR;
  sc_core::sc_out< sc_dt::sc_bv<32> > M_AXI_GP0_AWADDR;
  sc_core::sc_out< sc_dt::sc_bv<32> > M_AXI_GP0_WDATA;
  sc_core::sc_out< sc_dt::sc_bv<4> > M_AXI_GP0_ARCACHE;
  sc_core::sc_out< sc_dt::sc_bv<4> > M_AXI_GP0_ARLEN;
  sc_core::sc_out< sc_dt::sc_bv<4> > M_AXI_GP0_ARQOS;
  sc_core::sc_out< sc_dt::sc_bv<4> > M_AXI_GP0_AWCACHE;
  sc_core::sc_out< sc_dt::sc_bv<4> > M_AXI_GP0_AWLEN;
  sc_core::sc_out< sc_dt::sc_bv<4> > M_AXI_GP0_AWQOS;
  sc_core::sc_out< sc_dt::sc_bv<4> > M_AXI_GP0_WSTRB;
  sc_core::sc_in< bool > M_AXI_GP0_ACLK;
  sc_core::sc_in< bool > M_AXI_GP0_ARREADY;
  sc_core::sc_in< bool > M_AXI_GP0_AWREADY;
  sc_core::sc_in< bool > M_AXI_GP0_BVALID;
  sc_core::sc_in< bool > M_AXI_GP0_RLAST;
  sc_core::sc_in< bool > M_AXI_GP0_RVALID;
  sc_core::sc_in< bool > M_AXI_GP0_WREADY;
  sc_core::sc_in< sc_dt::sc_bv<12> > M_AXI_GP0_BID;
  sc_core::sc_in< sc_dt::sc_bv<12> > M_AXI_GP0_RID;
  sc_core::sc_in< sc_dt::sc_bv<2> > M_AXI_GP0_BRESP;
  sc_core::sc_in< sc_dt::sc_bv<2> > M_AXI_GP0_RRESP;
  sc_core::sc_in< sc_dt::sc_bv<32> > M_AXI_GP0_RDATA;
  sc_core::sc_out< bool > FCLK_CLK0;
  sc_core::sc_out< bool > FCLK_RESET0_N;
  sc_core::sc_out< sc_dt::sc_bv<54> > MIO;
  sc_core::sc_out< bool > DDR_CAS_n;
  sc_core::sc_out< bool > DDR_CKE;
  sc_core::sc_out< bool > DDR_Clk_n;
  sc_core::sc_out< bool > DDR_Clk;
  sc_core::sc_out< bool > DDR_CS_n;
  sc_core::sc_out< bool > DDR_DRSTB;
  sc_core::sc_out< bool > DDR_ODT;
  sc_core::sc_out< bool > DDR_RAS_n;
  sc_core::sc_out< bool > DDR_WEB;
  sc_core::sc_out< sc_dt::sc_bv<3> > DDR_BankAddr;
  sc_core::sc_out< sc_dt::sc_bv<15> > DDR_Addr;
  sc_core::sc_out< bool > DDR_VRN;
  sc_core::sc_out< bool > DDR_VRP;
  sc_core::sc_out< sc_dt::sc_bv<4> > DDR_DM;
  sc_core::sc_out< sc_dt::sc_bv<32> > DDR_DQ;
  sc_core::sc_out< sc_dt::sc_bv<4> > DDR_DQS_n;
  sc_core::sc_out< sc_dt::sc_bv<4> > DDR_DQS;
  sc_core::sc_out< bool > PS_SRSTB;
  sc_core::sc_out< bool > PS_CLK;
  sc_core::sc_out< bool > PS_PORB;

  // Dummy Signals for IP Ports


protected:

  virtual void before_end_of_elaboration();

private:

  xtlm::xaximm_xtlm2pin_t<32,32,12,1,1,1,1,1>* mp_M_AXI_GP0_transactor;
  xsc::common::scalar2vectorN_converter<2>* mp_M_AXI_GP0_ARLOCK_converter;
  sc_signal< bool > m_M_AXI_GP0_ARLOCK_converter_signal;
  xsc::common::scalar2vectorN_converter<2>* mp_M_AXI_GP0_AWLOCK_converter;
  sc_signal< bool > m_M_AXI_GP0_AWLOCK_converter_signal;
  xsc::common::vector2vector_converter<8,4>* mp_M_AXI_GP0_ARLEN_converter;
  sc_signal< sc_bv<8> > m_M_AXI_GP0_ARLEN_converter_signal;
  xsc::common::vector2vector_converter<8,4>* mp_M_AXI_GP0_AWLEN_converter;
  sc_signal< sc_bv<8> > m_M_AXI_GP0_AWLEN_converter_signal;
  sc_signal< bool > m_M_AXI_GP0_transactor_rst_signal;

  // Transactor stubs
  xtlm::xtlm_aximm_initiator_stub * M_AXI_GP0_transactor_initiator_rd_socket_stub;
  xtlm::xtlm_aximm_initiator_stub * M_AXI_GP0_transactor_initiator_wr_socket_stub;

  // Socket stubs

};
#endif // VCSSYSTEMC




#ifdef MTI_SYSTEMC
#include "utils/xtlm_aximm_initiator_stub.h"

class DllExport system_processing_system7_0_0 : public system_processing_system7_0_0_sc
{
public:

  system_processing_system7_0_0(const sc_core::sc_module_name& nm);
  virtual ~system_processing_system7_0_0();

  // module pin-to-pin RTL interface

  sc_core::sc_out< sc_dt::sc_bv<2> > USB0_PORT_INDCTL;
  sc_core::sc_out< bool > USB0_VBUS_PWRSELECT;
  sc_core::sc_in< bool > USB0_VBUS_PWRFAULT;
  sc_core::sc_out< bool > M_AXI_GP0_ARVALID;
  sc_core::sc_out< bool > M_AXI_GP0_AWVALID;
  sc_core::sc_out< bool > M_AXI_GP0_BREADY;
  sc_core::sc_out< bool > M_AXI_GP0_RREADY;
  sc_core::sc_out< bool > M_AXI_GP0_WLAST;
  sc_core::sc_out< bool > M_AXI_GP0_WVALID;
  sc_core::sc_out< sc_dt::sc_bv<12> > M_AXI_GP0_ARID;
  sc_core::sc_out< sc_dt::sc_bv<12> > M_AXI_GP0_AWID;
  sc_core::sc_out< sc_dt::sc_bv<12> > M_AXI_GP0_WID;
  sc_core::sc_out< sc_dt::sc_bv<2> > M_AXI_GP0_ARBURST;
  sc_core::sc_out< sc_dt::sc_bv<2> > M_AXI_GP0_ARLOCK;
  sc_core::sc_out< sc_dt::sc_bv<3> > M_AXI_GP0_ARSIZE;
  sc_core::sc_out< sc_dt::sc_bv<2> > M_AXI_GP0_AWBURST;
  sc_core::sc_out< sc_dt::sc_bv<2> > M_AXI_GP0_AWLOCK;
  sc_core::sc_out< sc_dt::sc_bv<3> > M_AXI_GP0_AWSIZE;
  sc_core::sc_out< sc_dt::sc_bv<3> > M_AXI_GP0_ARPROT;
  sc_core::sc_out< sc_dt::sc_bv<3> > M_AXI_GP0_AWPROT;
  sc_core::sc_out< sc_dt::sc_bv<32> > M_AXI_GP0_ARADDR;
  sc_core::sc_out< sc_dt::sc_bv<32> > M_AXI_GP0_AWADDR;
  sc_core::sc_out< sc_dt::sc_bv<32> > M_AXI_GP0_WDATA;
  sc_core::sc_out< sc_dt::sc_bv<4> > M_AXI_GP0_ARCACHE;
  sc_core::sc_out< sc_dt::sc_bv<4> > M_AXI_GP0_ARLEN;
  sc_core::sc_out< sc_dt::sc_bv<4> > M_AXI_GP0_ARQOS;
  sc_core::sc_out< sc_dt::sc_bv<4> > M_AXI_GP0_AWCACHE;
  sc_core::sc_out< sc_dt::sc_bv<4> > M_AXI_GP0_AWLEN;
  sc_core::sc_out< sc_dt::sc_bv<4> > M_AXI_GP0_AWQOS;
  sc_core::sc_out< sc_dt::sc_bv<4> > M_AXI_GP0_WSTRB;
  sc_core::sc_in< bool > M_AXI_GP0_ACLK;
  sc_core::sc_in< bool > M_AXI_GP0_ARREADY;
  sc_core::sc_in< bool > M_AXI_GP0_AWREADY;
  sc_core::sc_in< bool > M_AXI_GP0_BVALID;
  sc_core::sc_in< bool > M_AXI_GP0_RLAST;
  sc_core::sc_in< bool > M_AXI_GP0_RVALID;
  sc_core::sc_in< bool > M_AXI_GP0_WREADY;
  sc_core::sc_in< sc_dt::sc_bv<12> > M_AXI_GP0_BID;
  sc_core::sc_in< sc_dt::sc_bv<12> > M_AXI_GP0_RID;
  sc_core::sc_in< sc_dt::sc_bv<2> > M_AXI_GP0_BRESP;
  sc_core::sc_in< sc_dt::sc_bv<2> > M_AXI_GP0_RRESP;
  sc_core::sc_in< sc_dt::sc_bv<32> > M_AXI_GP0_RDATA;
  sc_core::sc_out< bool > FCLK_CLK0;
  sc_core::sc_out< bool > FCLK_RESET0_N;
  sc_core::sc_out< sc_dt::sc_bv<54> > MIO;
  sc_core::sc_out< bool > DDR_CAS_n;
  sc_core::sc_out< bool > DDR_CKE;
  sc_core::sc_out< bool > DDR_Clk_n;
  sc_core::sc_out< bool > DDR_Clk;
  sc_core::sc_out< bool > DDR_CS_n;
  sc_core::sc_out< bool > DDR_DRSTB;
  sc_core::sc_out< bool > DDR_ODT;
  sc_core::sc_out< bool > DDR_RAS_n;
  sc_core::sc_out< bool > DDR_WEB;
  sc_core::sc_out< sc_dt::sc_bv<3> > DDR_BankAddr;
  sc_core::sc_out< sc_dt::sc_bv<15> > DDR_Addr;
  sc_core::sc_out< bool > DDR_VRN;
  sc_core::sc_out< bool > DDR_VRP;
  sc_core::sc_out< sc_dt::sc_bv<4> > DDR_DM;
  sc_core::sc_out< sc_dt::sc_bv<32> > DDR_DQ;
  sc_core::sc_out< sc_dt::sc_bv<4> > DDR_DQS_n;
  sc_core::sc_out< sc_dt::sc_bv<4> > DDR_DQS;
  sc_core::sc_out< bool > PS_SRSTB;
  sc_core::sc_out< bool > PS_CLK;
  sc_core::sc_out< bool > PS_PORB;

  // Dummy Signals for IP Ports


protected:

  virtual void before_end_of_elaboration();

private:

  xtlm::xaximm_xtlm2pin_t<32,32,12,1,1,1,1,1>* mp_M_AXI_GP0_transactor;
  xsc::common::scalar2vectorN_converter<2>* mp_M_AXI_GP0_ARLOCK_converter;
  sc_signal< bool > m_M_AXI_GP0_ARLOCK_converter_signal;
  xsc::common::scalar2vectorN_converter<2>* mp_M_AXI_GP0_AWLOCK_converter;
  sc_signal< bool > m_M_AXI_GP0_AWLOCK_converter_signal;
  xsc::common::vector2vector_converter<8,4>* mp_M_AXI_GP0_ARLEN_converter;
  sc_signal< sc_bv<8> > m_M_AXI_GP0_ARLEN_converter_signal;
  xsc::common::vector2vector_converter<8,4>* mp_M_AXI_GP0_AWLEN_converter;
  sc_signal< sc_bv<8> > m_M_AXI_GP0_AWLEN_converter_signal;
  sc_signal< bool > m_M_AXI_GP0_transactor_rst_signal;

  // Transactor stubs
  xtlm::xtlm_aximm_initiator_stub * M_AXI_GP0_transactor_initiator_rd_socket_stub;
  xtlm::xtlm_aximm_initiator_stub * M_AXI_GP0_transactor_initiator_wr_socket_stub;

  // Socket stubs

};
#endif // MTI_SYSTEMC
#endif // IP_SYSTEM_PROCESSING_SYSTEM7_0_0_H_
