btao732/ECE492/(commit log)

2023-03-03 Init commit
    [SPARC Capstone Preliminary BOM.xlsx]
2023-03-03 Fixed prices and references
    [SPARC Capstone Preliminary BOM.xlsx]
2023-03-03 Added PCB KiCad Project
    [SPARC-B_Cu.gbr, SPARC-B_Mask.gbr, SPARC-B_Paste.gbr, SPARC-B_Silkscreen.gbr, SPARC-Edge_Cuts.gbr, SPARC-F_Cu.gbr, SPARC-F_Mask.gbr, SPARC-F_Paste.gbr]
2023-03-03 Updated gitignore for KiCad
2023-03-04 Worked on adding second channel
    [SPARC.kicad_pcb, SPARC.kicad_sch]
2023-03-04 Worked on fillers
    [SPARC.kicad_sch]
2023-03-05 voltage encoding
2023-03-07 Changed resistors and added jumpers
    [SPARC.kicad_pcb]
2023-03-08 Finished traces, finalized board
    [SPARC.kicad_pcb, SPARC.kicad_sch]
2023-03-08 Updated BOM
2023-03-08 Added BOM
    [SPARC Capstone Preliminary BOM.xlsx]
2023-03-08 Updated R20 & R32 connection
    [SPARC.kicad_pcb]
2023-03-08 Updated R20 & R32 routing
    [SPARC.kicad_sch]
2023-03-09 Reworked mode select jumpers
    [SPARC.kicad_pcb, SPARC.kicad_sch]
2023-03-09 Updated BOM to optimize costs
    [SPARC Capstone Preliminary BOM.xlsx, SPARC.kicad_pcb]
2023-03-09 Removed extraneous BOM
    [SPARC Capstone Preliminary BOM.xlsx]
2023-03-09 Updated BOMs
    [SPARC Capstone Preliminary BOM.xlsx]
2023-03-09 Updated 3D model for HV2621
    [SPARC.kicad_pcb, SPARC.kicad_sch]
2023-03-22 DMA system
2023-04-08 Add files via upload
    DMA loopback test simple mode
